AbhirajBhashkar/AutoGarden/(commit log)

2026-05-21 upload files from Arduino IDE
2026-08-14 Upload V2allsystems.ino
    Current code for V2
2026-08-14 Rename Assembly 1 Drawing 1 (1).png to Assembly Drawing.png
2026-08-14 Rename Assembly Drawing.png to AssemblyDrawing.png
